vickussya/baya_feeder/docs/checks.md

# Design checks (generated by build.py - do not edit by hand)

Parameters: wheel 80 mm x 28 mm, 6 pockets, bowl 140 x 45 mm, chute 60 deg

## Dosing

* Pocket volume (computed from the wheel solid, incl. fillets): **10.48 ml** (sharp-edged sector solid: 10.39 ml)
* Grams per pocket at 0.65 g/ml: **6.81 g**
* Dose 10 g -> 1 pockets = 6.8 g  (60 deg of wheel rotation)
* Dose 20 g -> 3 pockets = 20.4 g  (180 deg of wheel rotation)
* Dose 40 g -> 6 pockets = 40.9 g  (360 deg of wheel rotation)
* Pocket mouth (tangential) = 36.0 mm = 7.2 x pellet diameter (requirement >= 3x); axial width 22 mm = 4.4x
* Wheel-to-housing clearance: radial 0.7 mm, axial 0.7 mm (crest fillet 1.5 mm)

## Hopper

* Usable capacity up to the fill line: **1200 ml** = 780 g of pellets (funnel 274 ml + cylinder 117.9 mm); total to the rim 1388 ml
* Days of food at 40 g/day (2 x 20 g): **19.5 days**; at the default 2 x 20 g/day: 19.5 days; at 2 x 10 g/day: 39.0 days
* Mouth inner diameter 100 mm (>= 90); funnel wall slopes +X 70.4 deg, -X 60.5 deg, +-Y 62.8 deg (all >= 60 deg from horizontal)

## Bowl

* Inner diameter at brim **140 mm**, inner depth **45 mm**, spherical dish radius 76.9 mm
* Volume to the brim: **394 ml**; volume below the low front rim: 78 ml (a 40 g dose = 62 ml)
* Front (rabbit-facing) rim height 32 mm above the ground; back/side rim 58 mm
* Base diameter 168 mm = 1.20 x bowl diameter (>= 1.2); steel weight plate 106 x 3.2 mm = 222 g

## Assembly geometry

| result | check | detail |
|---|---|---|
| PASS | Chute outlet over bowl centre | outlet centre x=140.5 mm, bowl centre x=140.5 mm; outlet spans 113..168 inside bowl radius 70 |
| PASS | Drop height outlet -> bowl floor 60-100 mm | 80.0 mm |
| PASS | Chute slope >= 60 deg from horizontal | 60 deg (30 deg from vertical) |
| PASS | Chute internal width 35-40 mm (>= 7x pellet) | 40 mm = 8.0x pellet diameter |
| PASS | Chute clears the bowl rim | 35.0 mm between outlet and rim top |
| PASS | Hopper stays on the housing side of the pen wall | hopper max x=45.8 mm, pen wall starts at x=49.5 mm |

## Print volume (220 x 220 x 250)

| result | part | bed footprint x height (mm) |
|---|---|---|
| PASS | 01_hopper_body | 107.6 x 110.6 x 222.9 |
| PASS | 02_hopper_lid | 107.6 x 107.6 x 21.0 |
| PASS | 03_wheel_housing | 91.0 x 92.8 x 40.1 |
| PASS | 03b_bearing_cap | 91.0 x 91.0 x 13.7 |
| PASS | 04_pocket_wheel | 80.0 x 80.0 x 44.7 |
| PASS | 05_motor_mount | 70.0 x 70.0 x 19.0 |
| PASS | 06_chute | 210.2 x 52.0 x 238.2 |
| PASS | 06b_chute_flap_TPU | 66.0 x 51.2 x 17.2 |
| PASS | 07_enclosure | 91.0 x 91.0 x 89.0 |
| PASS | 07b_enclosure_lid | 91.0 x 91.0 x 10.0 |
| PASS | 08_bowl | 134.2 x 146.9 x 49.0 |
| PASS | 09_bowl_base | 168.0 x 168.0 x 16.0 |
| PASS | 10_wall_bracket | 212.8 x 150.0 x 4.0 |

## Minimum wall thickness (designed values; slicer: >= 4 perimeters, 100% on chute/bowl)

| result | feature | thickness (mm) | limit |
|---|---|---|---|
| PASS | Chute tube wall (reachable) | 4.00 | >= 3.0 |
| PASS | Chute flange (reachable end is the tube, flange is outside) | 5.00 | >= 2.4 |
| PASS | Bowl dish wall (min normal distance, sampled) | 3.87 | >= 3.0 |
| PASS | Bowl floor | 4.00 | >= 3.0 |
| PASS | Bowl base: floor under recess | 6.00 | >= 3.0 |
| PASS | Bowl base: floor under M4 counterbore | 3.80 | >= 3.0 |
| PASS | Bracket plate | 4.00 | >= 3.0 |
| PASS | Hopper cylinder wall | 3.80 | >= 2.4 |
| PASS | Hopper funnel wall (normal) | 3.31 | >= 2.4 |
| PASS | Hopper window wall behind strip | 2.80 | >= 2.4 |
| PASS | Hopper lid disc under finger dish | 2.80 | >= 2.4 |
| PASS | Hopper lid under gasket groove | 3.50 | >= 2.4 |
| PASS | Hopper lid plug ring | 5.50 | >= 2.4 |
| PASS | Flange under groove | 2.80 | >= 2.4 |
| PASS | Housing side wall (HB - R_i) | 4.80 | >= 2.4 |
| PASS | Housing motor-side wall | 8.00 | >= 2.4 |
| PASS | Housing wall behind reed pocket | 3.00 | >= 2.4 |
| PASS | Housing wall under insert holes | 3.00 | >= 2.4 |
| PASS | Housing tongue ridge | 2.40 | >= 2.4 |
| PASS | Bearing cap | 8.00 | >= 2.4 |
| PASS | Wheel side wall | 3.00 | >= 2.4 |
| PASS | Wheel web between pockets | 4.00 | >= 2.4 |
| PASS | Wheel hub around D-bore | 5.40 | >= 2.4 |
| PASS | Motor-mount post around screw hole | 2.80 | >= 2.4 |
| PASS | Motor-mount plate | 5.00 | >= 2.4 |
| PASS | Enclosure wall | 3.00 | >= 2.4 |
| PASS | Enclosure lid | 4.00 | >= 2.4 |

Intentionally thin (TPU, not subject to the rule): chute flap 1.2 mm, living hinge 0.6 mm, sleeve 2.0 mm.

## Entrapment gaps on rabbit-reachable surfaces (forbidden window 6-25 mm)

| result | gap | size (mm) | note |
|---|---|---|---|
| PASS | Chute <-> bracket plate hole | 0.4 | chute leaves the pen wall through the plate |
| PASS | Bowl cone <-> base recess wall (at base top) | 1.0 | bowl sits in a recess |
| PASS | Bowl foot <-> recess wall (hidden underneath) | 4.4 | below the bowl, no access |
| PASS | Chute outlet <-> bowl brim (vertical) | 35.0 | open space, head can pass |
| PASS | Chute outlet <-> front rim notch floor | 61.2 | open space |
| PASS | Hopper window slot (8 mm) - covered by 1 mm strip, out of reach | 0.0 | covered, no opening |
| PASS | Bracket slots (5 x 14 mm), outside the pen | 5.0 | narrow dimension < 6 |

The pen wall / bars themselves are the user's: leave a hole of about 49 mm wide x 96 mm high (the bracket plate closes it to 0.4 mm).

## Interference check of the assembled parts

* intended stretch fit (TPU sleeve over chute end): 06_chute / 06b_chute_flap_TPU = 1326 mm3 (0.4 mm interference)
* PASS: no volumetric overlap between any of the 13 parts (threshold 5 mm3 = touching faces)

## Overall: ALL CHECKS PASS
## STL validation (reloaded with trimesh)

| result | file | triangles | volume (ml) | extents (mm) |
|---|---|---|---|---|
| PASS | stl/01_hopper_body.stl | 7612 | 258.6 | 107.6 x 110.6 x 222.9 |
| PASS | stl/02_hopper_lid.stl | 12614 | 68.5 | 107.6 x 107.6 x 21.0 |
| PASS | stl/03_wheel_housing.stl | 14144 | 142.0 | 91.0 x 92.8 x 40.1 |
| PASS | stl/03b_bearing_cap.stl | 3060 | 65.8 | 91.0 x 91.0 x 13.7 |
| PASS | stl/04_pocket_wheel.stl | 5510 | 80.9 | 80.0 x 80.0 x 44.7 |
| PASS | stl/05_motor_mount.stl | 7112 | 25.1 | 70.0 x 70.0 x 19.0 |
| PASS | stl/06_chute.stl | 2080 | 202.0 | 210.2 x 52.0 x 238.2 |
| PASS | stl/06b_chute_flap_TPU.stl | 76 | 9.8 | 66.0 x 51.2 x 17.2 |
| PASS | stl/07_enclosure.stl | 6232 | 125.3 | 91.0 x 91.0 x 89.0 |
| PASS | stl/07b_enclosure_lid.stl | 9168 | 32.2 | 91.0 x 91.0 x 10.0 |
| PASS | stl/08_bowl.stl | 55774 | 194.4 | 134.2 x 146.9 x 49.0 |
| PASS | stl/09_bowl_base.stl | 20168 | 259.1 | 168.0 x 167.9 x 16.0 |
| PASS | stl/10_wall_bracket.stl | 2656 | 107.2 | 212.8 x 150.0 x 4.0 |
