vickussya/baya_feeder/step/rabbit_feeder_assembly.step

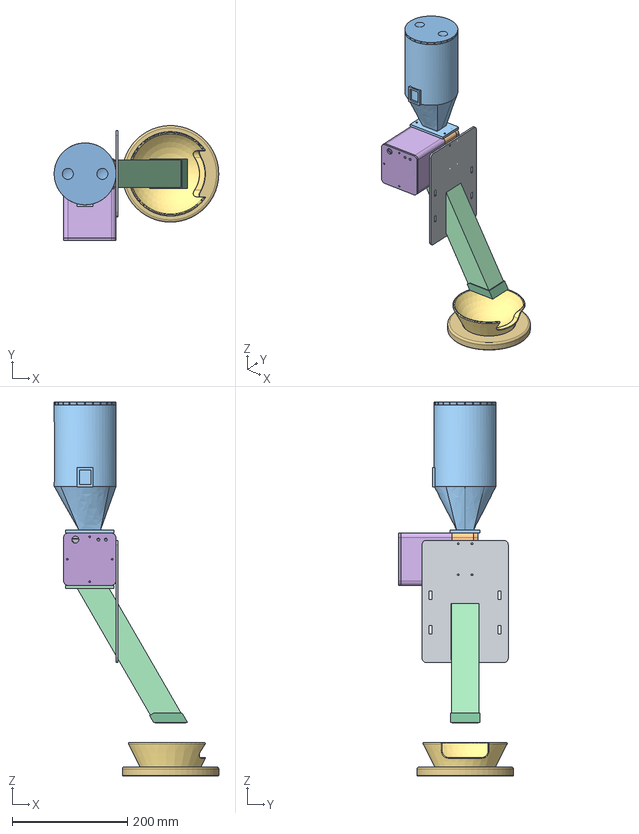
[picture p8: CAD file, 2026-10-19]
step/rabbit_feeder_assembly.step
286.3 x 199.7 x 650.2 mm
01_hopper_body
02_hopper_lid
03_wheel_housing
03b_bearing_cap
04_pocket_wheel
05_motor_mount
06_chute
06b_chute_flap_TPU
07_enclosure
07b_enclosure_lid
08_bowl
09_bowl_base
10_wall_bracket
