vickussya/baya_feeder/step/03b_bearing_cap.step

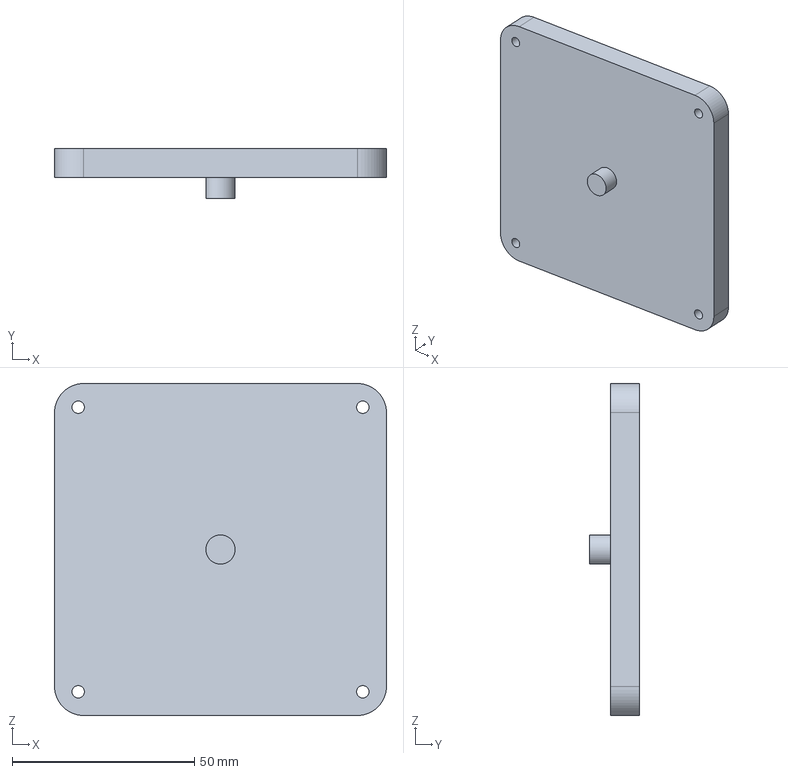
[picture p9: CAD file, 2026-10-19]
step/03b_bearing_cap.step
91.0 x 13.7 x 91.0 mm
