vickussya/baya_feeder/step/10_wall_bracket.step

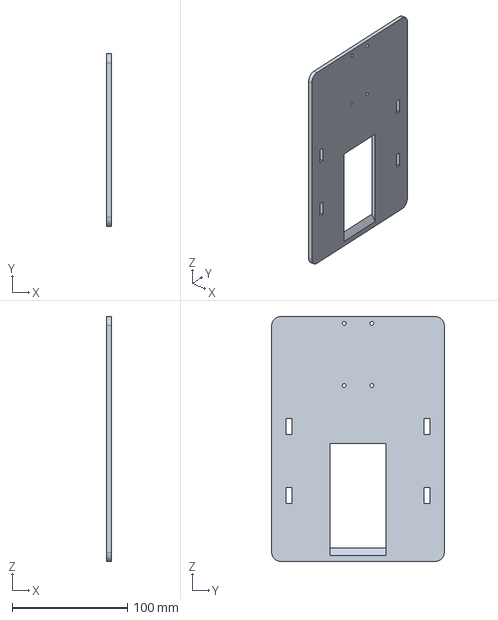
[picture p10: CAD file, 2026-10-19]
step/10_wall_bracket.step
4.00 x 150.0 x 212.8 mm
