vickussya/baya_feeder/step/07_enclosure.step

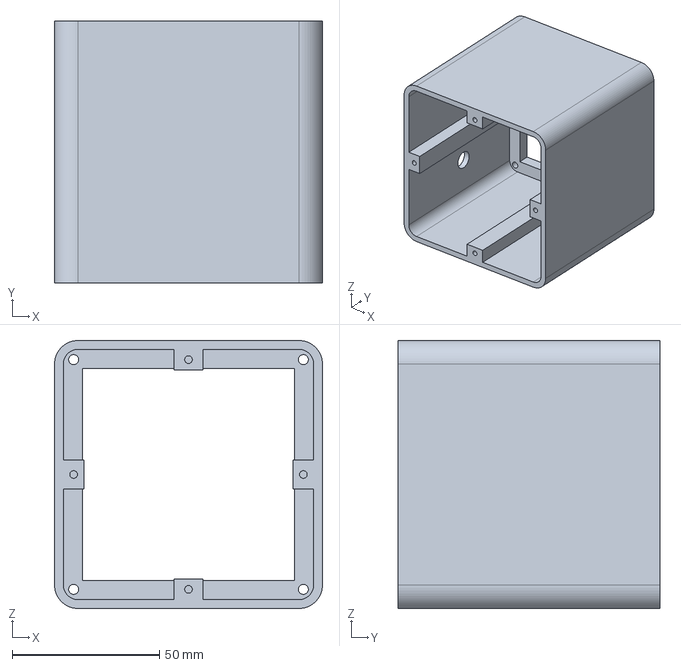
[picture p11: CAD file, 2026-10-19]
step/07_enclosure.step
91.0 x 89.0 x 91.0 mm
