vickussya/baya_feeder/step/06b_chute_flap_TPU.step

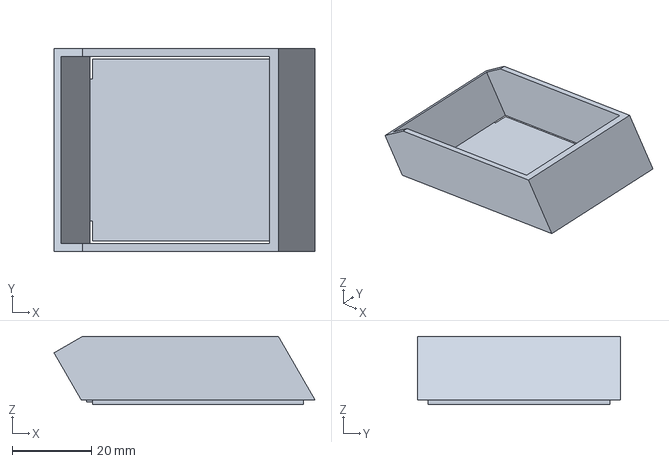
[picture p12: CAD file, 2026-10-19]
step/06b_chute_flap_TPU.step
66.0 x 51.2 x 17.2 mm
