vickussya/baya_feeder/step/01_hopper_body.step

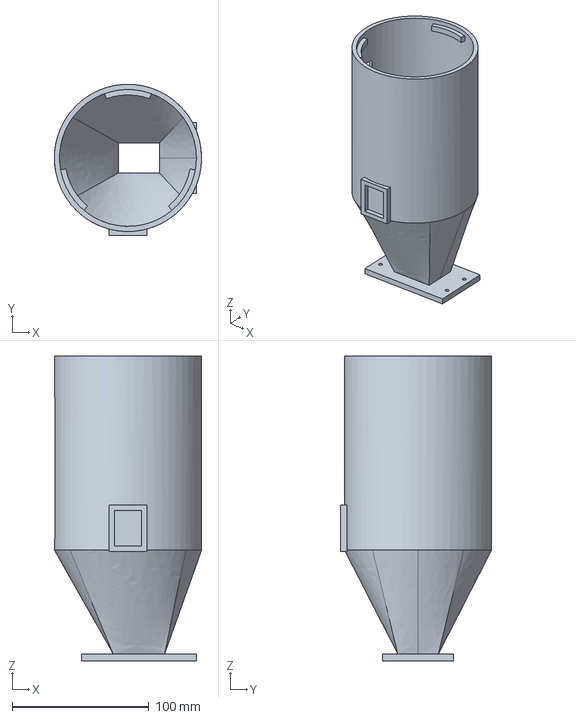
[picture p13: CAD file, 2026-10-19]
step/01_hopper_body.step
107.5 x 110.6 x 222.9 mm
