vickussya/baya_feeder/step/07b_enclosure_lid.step

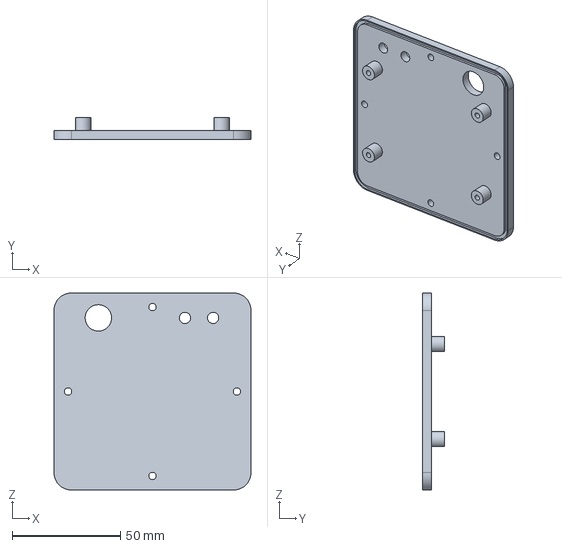
[picture p14: CAD file, 2026-10-19]
step/07b_enclosure_lid.step
91.0 x 10.0 x 91.0 mm
