vickussya/baya_feeder/step/02_hopper_lid.step

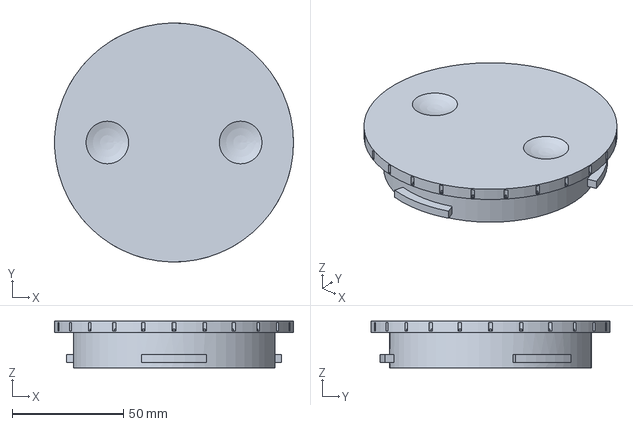
[picture p15: CAD file, 2026-10-19]
step/02_hopper_lid.step
107.6 x 107.6 x 21.0 mm
