vickussya/baya_feeder/step/08_bowl.step

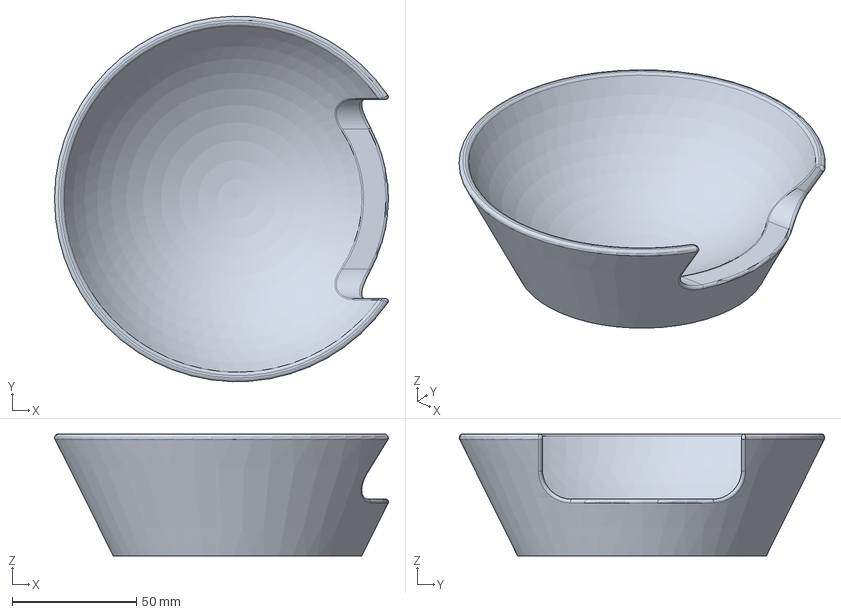
[picture p16: CAD file, 2026-10-19]
step/08_bowl.step
134.2 x 146.9 x 49.0 mm
