vickussya/baya_feeder/step/09_bowl_base.step

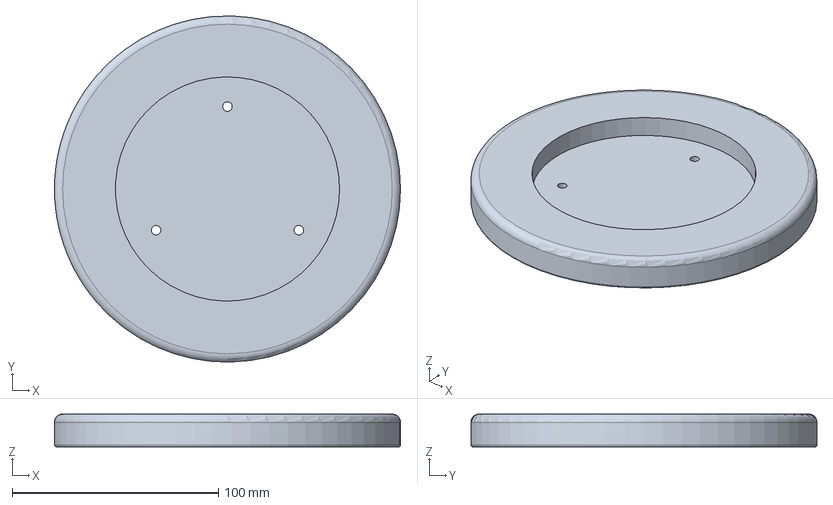
[picture p17: CAD file, 2026-10-19]
step/09_bowl_base.step
168.0 x 167.9 x 16.0 mm
