vickussya/baya_feeder/step/05_motor_mount.step

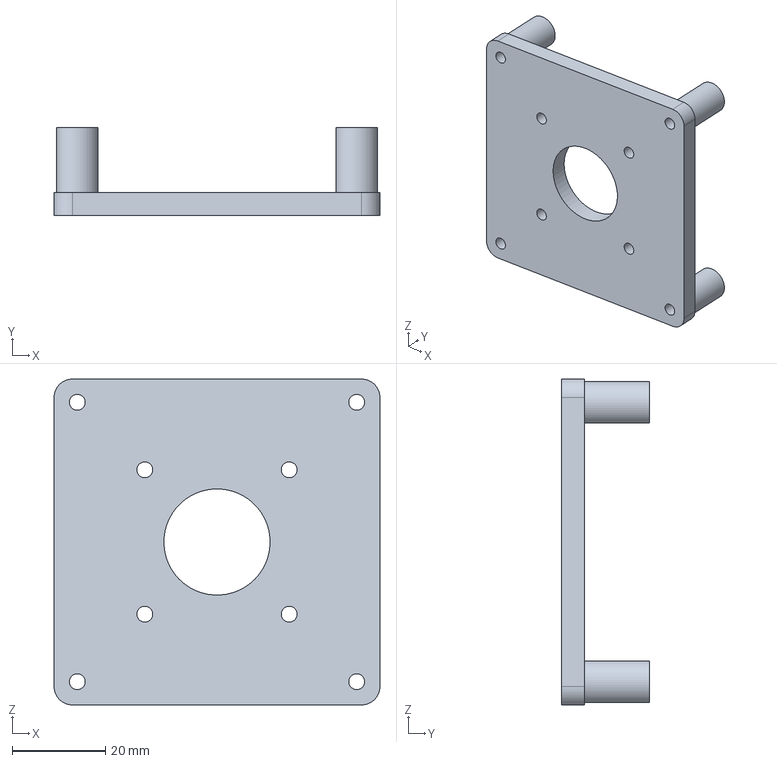
[picture p18: CAD file, 2026-10-19]
step/05_motor_mount.step
70.0 x 19.0 x 70.0 mm
