vickussya/baya_feeder/step/06_chute.step

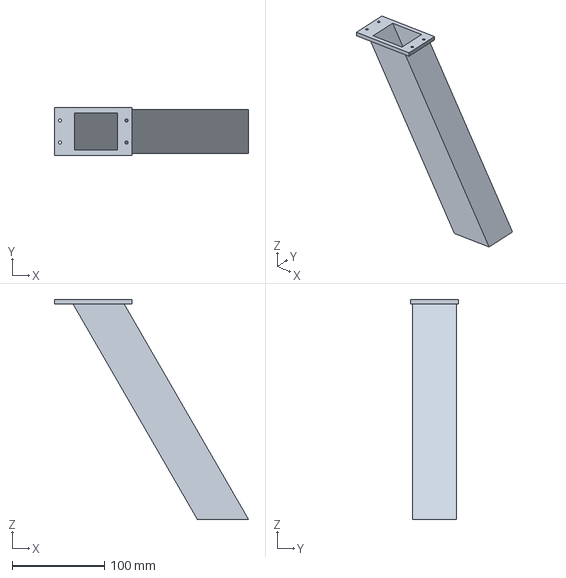
[picture p19: CAD file, 2026-10-19]
step/06_chute.step
210.2 x 52.0 x 238.2 mm
