vickussya/baya_feeder/step/03_wheel_housing.step

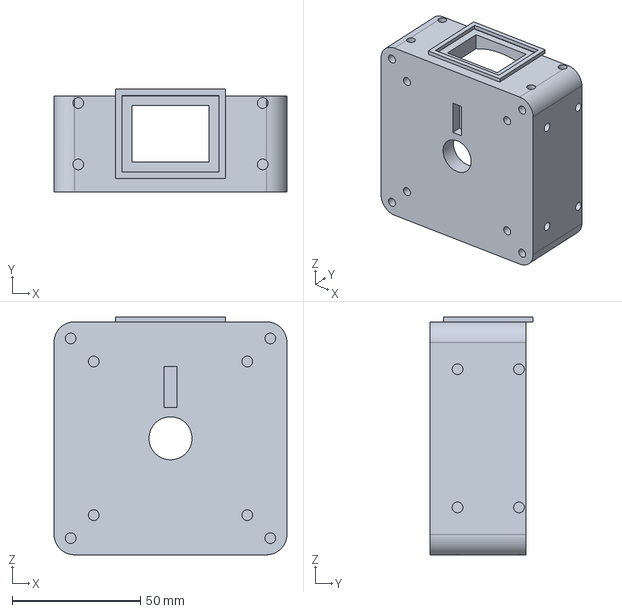
[picture p20: CAD file, 2026-10-19]
step/03_wheel_housing.step
91.0 x 40.1 x 92.8 mm
