vickussya/baya_feeder/step/04_pocket_wheel.step

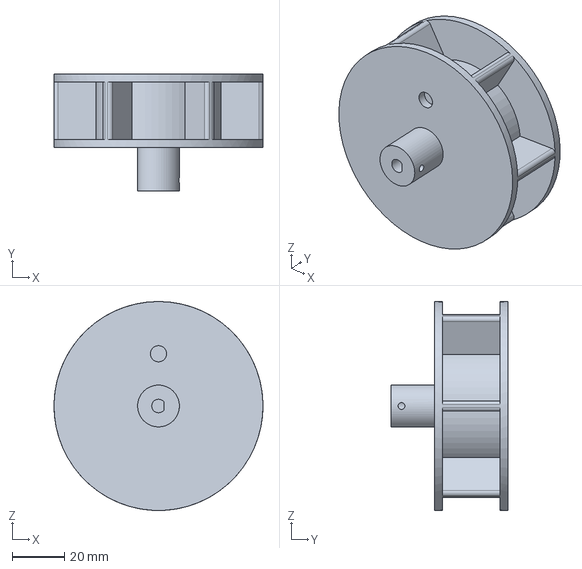
[picture p21: CAD file, 2026-10-19]
step/04_pocket_wheel.step
80.0 x 44.7 x 80.0 mm
