vickussya/baya_feeder/(list of files, cad)

Other CAD files:
baya feeder.FCStd
stl/01_hopper_body.stl
stl/02_hopper_lid.stl
stl/03_wheel_housing.stl
stl/03b_bearing_cap.stl
stl/04_pocket_wheel.stl
stl/05_motor_mount.stl
stl/06_chute.stl
stl/06b_chute_flap_TPU.stl
stl/07_enclosure.stl
stl/07b_enclosure_lid.stl
stl/08_bowl.stl
stl/09_bowl_base.stl
stl/10_wall_bracket.stl
