vickussya/baya_feeder/build.py

#!/usr/bin/env python3
"""
Build driver for feeder.py:  STL export, design checks (docs/checks.md) and the assembly render.

    python build.py            # everything
    python build.py --no-render
"""
import itertools
import math
import os
import sys
import time

import numpy as np
import trimesh
from PIL import Image, ImageDraw, ImageFont

import feeder as f
from feeder import V

HERE = os.path.dirname(os.path.abspath(__file__))
STL_DIR = os.path.join(HERE, "stl")
DOC_DIR = os.path.join(HERE, "docs")

COLORS = {
    "01_hopper_body": (86, 156, 214), "02_hopper_lid": (46, 108, 168),
    "03_wheel_housing": (232, 150, 60), "03b_bearing_cap": (200, 120, 40),
    "04_pocket_wheel": (220, 70, 70), "05_motor_mount": (120, 120, 130),
    "06_chute": (90, 180, 120), "06b_chute_flap_TPU": (30, 120, 70),
    "07_enclosure": (150, 110, 190), "07b_enclosure_lid": (120, 80, 160),
    "08_bowl": (240, 205, 80), "09_bowl_base": (170, 140, 60),
    "10_wall_bracket": (150, 160, 170),
}
INTENDED_FIT = {("06_chute", "06b_chute_flap_TPU")}
LABELS = {
    "01_hopper_body": "1  Hopper body", "02_hopper_lid": "2  Hopper lid (bayonet)",
    "03_wheel_housing": "3  Wheel housing", "03b_bearing_cap": "3b Bearing cap",
    "04_pocket_wheel": "4  Pocket wheel (6x)", "05_motor_mount": "5  Motor mount",
    "06_chute": "6  Chute", "06b_chute_flap_TPU": "6b Chute flap (TPU)",
    "07_enclosure": "7  Electronics enclosure", "07b_enclosure_lid": "7b Enclosure lid",
    "08_bowl": "8  Bowl", "09_bowl_base": "9  Bowl base + weight",
    "10_wall_bracket": "10 Wall / cage bracket",
}


# =============================================================================
# CHECKS
# =============================================================================
def run_checks(parts):
    L = []                     # markdown lines
    ok_all = True

    def line(s=""):
        L.append(s)

    def check(name, cond, detail):
        nonlocal ok_all
        ok_all &= bool(cond)
        line(f"| {'PASS' if cond else '**FAIL**'} | {name} | {detail} |")

    line("# Design checks (generated by build.py - do not edit by hand)\n")
    line(f"Parameters: wheel {f.wheel_od:.0f} mm x {f.wheel_w:.0f} mm, {f.n_pockets} pockets, "
         f"bowl {f.bowl_diameter:.0f} x {f.bowl_depth:.0f} mm, chute {f.chute_angle:.0f} deg\n")

    # ---- dosing --------------------------------------------------------------
    wheel = parts["04_pocket_wheel"]
    pocket_ml = f.pocket_volume_ml(wheel)
    pocket_g = pocket_ml * f.bulk_density
    line("## Dosing\n")
    line(f"* Pocket volume (computed from the wheel solid, incl. fillets): **{pocket_ml:.2f} ml** "
         f"(sharp-edged sector solid: {f.vol_ml(f.pocket_prism(f.R_w)):.2f} ml)")
    line(f"* Grams per pocket at {f.bulk_density} g/ml: **{pocket_g:.2f} g**")
    for g in (f.dose_min_g, f.dose_default_g, f.dose_max_g):
        n = round(g / pocket_g)
        line(f"* Dose {g:.0f} g -> {n} pockets = {n * pocket_g:.1f} g  ({n * 360 // f.n_pockets} deg of wheel rotation)")
    pockets_default = round(f.dose_default_g / pocket_g)
    mouth = 2 * f.R_w * math.sin(math.radians(180 / f.n_pockets)) - f.pocket_web
    line(f"* Pocket mouth (tangential) = {mouth:.1f} mm = {mouth / f.pellet_diameter:.1f} x pellet diameter "
         f"(requirement >= 3x); axial width {f.pocket_w:.0f} mm = {f.pocket_w / f.pellet_diameter:.1f}x")
    line(f"* Wheel-to-housing clearance: radial {f.wheel_clear} mm, axial {f.wheel_clear} mm (crest fillet {f.pocket_rim_fillet} mm)\n")

    # ---- hopper --------------------------------------------------------------
    funnel_ml = f.V_funnel_ml
    usable_ml = funnel_ml + math.pi * (f.hopper_d_in / 2) ** 2 * f.cyl_h / 1000
    total_ml = usable_ml + math.pi * (f.hopper_d_in / 2) ** 2 * f.headroom / 1000
    grams = usable_ml * f.bulk_density
    run_x_plus = (f.hopper_d_in / 2 + f.hopper_dx) - f.port_top_x / 2
    run_x_minus = (f.hopper_d_in / 2 - f.hopper_dx) - f.port_top_x / 2
    run_y = f.hopper_d_in / 2 - f.pocket_w / 2
    slopes = {k: math.degrees(math.atan2(f.funnel_h, r)) for k, r in
              (("+X", run_x_plus), ("-X", run_x_minus), ("+-Y", run_y))}
    line("## Hopper\n")
    line(f"* Usable capacity up to the fill line: **{usable_ml:.0f} ml** = {grams:.0f} g of pellets "
         f"(funnel {funnel_ml:.0f} ml + cylinder {f.cyl_h:.1f} mm); total to the rim {total_ml:.0f} ml")
    line(f"* Days of food at {f.fed_g_per_day_max:.0f} g/day (2 x {f.dose_max_g / 2:.0f} g): "
         f"**{grams / f.fed_g_per_day_max:.1f} days**; at the default 2 x {f.dose_default_g:.0f} g/day: "
         f"{grams / (f.dose_default_g * 2):.1f} days; at 2 x {f.dose_min_g:.0f} g/day: {grams / (f.dose_min_g * 2):.1f} days")
    line(f"* Mouth inner diameter {f.hopper_d_in:.0f} mm (>= 90); funnel wall slopes "
         + ", ".join(f"{k} {v:.1f} deg" for k, v in slopes.items()) + " (all >= 60 deg from horizontal)\n")

    # ---- bowl ----------------------------------------------------------------
    cav_ml = f.bowl_cavity_volume_ml()
    outer, cav = f._bowl_local()
    front = f.I(cav, f.box(-f.R_cap - 1, f.R_cap + 1, -f.R_cap - 1, f.R_cap + 1, 0, f.bowl_front_z))
    front_ml = front.Volume() / 1000
    line("## Bowl\n")
    line(f"* Inner diameter at brim **{f.bowl_diameter:.0f} mm**, inner depth **{f.bowl_depth:.0f} mm**, "
         f"spherical dish radius {f.R_cap:.1f} mm")
    line(f"* Volume to the brim: **{cav_ml:.0f} ml**; volume below the low front rim: {front_ml:.0f} ml "
         f"(a {f.dose_max_g:.0f} g dose = {f.dose_max_g / f.bulk_density:.0f} ml)")
    line(f"* Front (rabbit-facing) rim height {f.rim_height:.0f} mm above the ground; back/side rim "
         f"{f.bowl_foot_z_above_ground + f.bowl_ztop:.0f} mm")
    line(f"* Base diameter {f.base_d:.0f} mm = {f.base_d / f.bowl_diameter:.2f} x bowl diameter (>= 1.2); "
         f"steel weight plate {f.weight_d:.0f} x {f.weight_t} mm = "
         f"{math.pi * (f.weight_d / 20) ** 2 * f.weight_t / 10 * f.steel_density:.0f} g\n")

    # ---- assembly geometry ---------------------------------------------------
    chute = parts["06_chute"]
    outlet_faces = [fc for fc in chute.Faces()
                    if abs(fc.normalAt().z + 1) < 1e-6 and abs(fc.Center().z - f.z_out) < 1e-3]
    out_cx = sum(fc.Center().x * fc.Area() for fc in outlet_faces) / sum(fc.Area() for fc in outlet_faces)
    bowl_world = parts["08_bowl"]
    bb_b = bowl_world.BoundingBox()
    rim_top_z = f.z_bowl_foot + f.bowl_ztop
    drop = f.z_out - (f.z_bowl_foot + f.bowl_floor_t)
    chute_min_z = chute.BoundingBox().zmin
    half_w = (f.chute_in + 2 * f.chute_wall) / f.sin_a / 2
    line("## Assembly geometry\n")
    line("| result | check | detail |")
    line("|---|---|---|")
    check("Chute outlet over bowl centre", abs(out_cx - f.x_bowl) < 0.5,
          f"outlet centre x={out_cx:.1f} mm, bowl centre x={f.x_bowl:.1f} mm; outlet spans "
          f"{out_cx - half_w:.0f}..{out_cx + half_w:.0f} inside bowl radius {f.bowl_diameter / 2:.0f}")
    check("Drop height outlet -> bowl floor 60-100 mm", 60 <= drop <= 100 and abs(chute_min_z - f.z_out) < 1e-3,
          f"{drop:.1f} mm")
    check("Chute slope >= 60 deg from horizontal", f.chute_angle >= 60, f"{f.chute_angle:.0f} deg "
          f"({90 - f.chute_angle:.0f} deg from vertical)")
    check("Chute internal width 35-40 mm (>= 7x pellet)", 35 <= f.chute_in <= 40 and f.chute_in >= 7 * f.pellet_diameter,
          f"{f.chute_in:.0f} mm = {f.chute_in / f.pellet_diameter:.1f}x pellet diameter")
    check("Chute clears the bowl rim", f.z_out - rim_top_z > 0, f"{f.z_out - rim_top_z:.1f} mm between outlet and rim top")
    check("Hopper stays on the housing side of the pen wall",
          f.hopper_dx + f.r_ho <= f.x_plate1 - 1.0, f"hopper max x={f.hopper_dx + f.r_ho:.1f} mm, "
          f"pen wall starts at x={f.x_plate1:.1f} mm")
    line()

    # ---- print volume ---------------------------------------------------------
    line("## Print volume (220 x 220 x 250)\n")
    line("| result | part | bed footprint x height (mm) |")
    line("|---|---|---|")
    pv = f.print_volume
    for name, shape in parts.items():
        bb = f.to_print(name, shape).BoundingBox()
        fits = (bb.xlen <= pv[0] and bb.ylen <= pv[1] or bb.xlen <= pv[1] and bb.ylen <= pv[0]) and bb.zlen <= pv[2]
        ok_all &= fits
        line(f"| {'PASS' if fits else '**FAIL**'} | {name} | {bb.xlen:.1f} x {bb.ylen:.1f} x {bb.zlen:.1f} |")
    line()

    # ---- wall thickness -------------------------------------------------------
    line("## Minimum wall thickness (designed values; slicer: >= 4 perimeters, 100% on chute/bowl)\n")
    line("| result | feature | thickness (mm) | limit |")
    line("|---|---|---|---|")
    funnel_wall_n = f.hop_wall * math.sin(math.radians(min(slopes.values())))
    # bowl: shortest distance from the dish surface to the outer cone profile
    th = bowl_min_wall()
    walls = [
        ("Chute tube wall (reachable)", f.chute_wall, f.wall_reach),
        ("Chute flange (reachable end is the tube, flange is outside)", f.flange_t, f.wall_min),
        ("Bowl dish wall (min normal distance, sampled)", th, f.wall_reach),
        ("Bowl floor", f.bowl_floor_t, f.wall_reach),
        ("Bowl base: floor under recess", f.base_t - f.base_recess_depth, f.wall_reach),
        ("Bowl base: floor under M4 counterbore", f.base_t - f.base_recess_depth - 2.2, f.wall_reach),
        ("Bracket plate", f.plate_t, f.wall_reach),
        ("Hopper cylinder wall", f.hop_wall, f.wall_min),
        ("Hopper funnel wall (normal)", funnel_wall_n, f.wall_min),
        ("Hopper window wall behind strip", f.hop_wall - f.window_strip_t, f.wall_min),
        ("Hopper lid disc under finger dish", f.lid_t - 2.2, f.wall_min),
        ("Hopper lid under gasket groove", f.lid_t - f.lid_gasket_d, f.wall_min),
        ("Hopper lid plug ring", 5.5, f.wall_min),
        ("Flange under groove", f.flange_t - (f.tongue_h + 0.4), f.wall_min),
        ("Housing side wall (HB - R_i)", f.HB - f.R_i, f.wall_min),
        ("Housing motor-side wall", f.housing_back_wall, f.wall_min),
        ("Housing wall behind reed pocket", f.housing_back_wall - 5.0, f.wall_min),
        ("Housing wall under insert holes", f.housing_back_wall - f.insert_depth, f.wall_min),
        ("Housing tongue ridge", f.tongue_w, f.wall_min),
        ("Bearing cap", f.cap_t, f.wall_min),
        ("Wheel side wall", f.wheel_side_wall, f.wall_min),
        ("Wheel web between pockets", f.pocket_web, f.wall_min),
        ("Wheel hub around D-bore", (f.hub_d - (f.shaft_d + 0.2)) / 2, f.wall_min),
        ("Motor-mount post around screw hole", (f.post_d - f.screw_clear_d) / 2, f.wall_min),
        ("Motor-mount plate", f.motor_plate_t, f.wall_min),
        ("Enclosure wall", f.enc_wall, f.wall_min),
        ("Enclosure lid", f.lid_enc_t, f.wall_min),
    ]
    for n, t, lim in walls:
        ok = t >= lim - 1e-9
        ok_all &= ok
        line(f"| {'PASS' if ok else '**FAIL**'} | {n} | {t:.2f} | >= {lim} |")
    line("\nIntentionally thin (TPU, not subject to the rule): chute flap 1.2 mm, living hinge 0.6 mm, sleeve 2.0 mm.\n")

    # ---- gaps -----------------------------------------------------------------
    line("## Entrapment gaps on rabbit-reachable surfaces (forbidden window 6-25 mm)\n")
    line("| result | gap | size (mm) | note |")
    line("|---|---|---|---|")
    r_recess = f.bowl_foot_d / 2 + f.base_recess_clear
    cone_r = f.bowl_foot_d / 2 + (f.bowl_rout_rim - f.bowl_foot_d / 2) * (f.base_t - f.bowl_foot_z_above_ground) / f.bowl_ztop
    gaps = [
        ("Chute <-> bracket plate hole", f.plate_hole_clear, "chute leaves the pen wall through the plate"),
        ("Bowl cone <-> base recess wall (at base top)", r_recess - cone_r, "bowl sits in a recess"),
        ("Bowl foot <-> recess wall (hidden underneath)", r_recess - f.bowl_foot_d / 2, "below the bowl, no access"),
        ("Chute outlet <-> bowl brim (vertical)", f.z_out - rim_top_z, "open space, head can pass"),
        ("Chute outlet <-> front rim notch floor", f.z_out - (f.z_bowl_foot + f.bowl_front_z), "open space"),
        ("Hopper window slot (8 mm) - covered by 1 mm strip, out of reach", 0.0, "covered, no opening"),
        ("Bracket slots (5 x 14 mm), outside the pen", 5.0, "narrow dimension < 6"),
    ]
    for n, g, note in gaps:
        ok = not (f.gap_forbidden[0] <= g <= f.gap_forbidden[1])
        ok_all &= ok
        line(f"| {'PASS' if ok else '**FAIL**'} | {n} | {g:.1f} | {note} |")
    line("\nThe pen wall / bars themselves are the user's: leave a hole of about "
         f"{f.chute_in + 2 * f.chute_wall + 2 * f.plate_hole_clear:.0f} mm wide x "
         f"{(f.chute_in + 2 * f.chute_wall) / f.cos_a:.0f} mm high (the bracket plate closes it to {f.plate_hole_clear} mm).\n")

    # ---- interferences --------------------------------------------------------
    line("## Interference check of the assembled parts\n")
    names = list(parts)
    bad = []
    for a, b in itertools.combinations(names, 2):
        ba, bb_ = parts[a].BoundingBox(), parts[b].BoundingBox()
        if (ba.xmax < bb_.xmin or bb_.xmax < ba.xmin or ba.ymax < bb_.ymin or bb_.ymax < ba.ymin
                or ba.zmax < bb_.zmin or bb_.zmax < ba.zmin):
            continue
        v = parts[a].intersect(parts[b]).Volume()
        if (a, b) in INTENDED_FIT:
            line(f"* intended stretch fit (TPU sleeve over chute end): {a} / {b} = {v:.0f} mm3 "
                 f"({f.chute_wall and 0.4} mm interference)")
            continue
        if v > 5.0:
            bad.append((a, b, v))
    if bad:
        ok_all = False
        for a, b, v in bad:
            line(f"* **FAIL** {a} intersects {b}: {v:.1f} mm3")
    else:
        line(f"* PASS: no volumetric overlap between any of the {len(names)} parts (threshold 5 mm3 = touching faces)")
    line()
    line(f"## Overall: {'ALL CHECKS PASS' if ok_all else 'SOME CHECKS FAILED'}")
    return "\n".join(L), ok_all


def bowl_min_wall():
    """min distance from the spherical dish surface to the outer cone profile (r,z plane)"""
    P = [(0, 0), (f.bowl_foot_d / 2, 0), (f.bowl_rout_rim, f.bowl_ztop)]
    best = 1e9
    for i in range(0, 361):
        ang = math.radians(i * 0.25)                                 # polar angle on the dish
        r, z = f.R_cap * math.sin(ang), f.bowl_zc - f.R_cap * math.cos(ang)
        if z > f.bowl_ztop or z < f.bowl_floor_t - 1e-9:
            continue
        for (x0, z0), (x1, z1) in zip(P[:-1], P[1:]):
            dx, dz = x1 - x0, z1 - z0
            t = max(0, min(1, ((r - x0) * dx + (z - z0) * dz) / (dx * dx + dz * dz)))
            best = min(best, math.hypot(r - (x0 + t * dx), z - (z0 + t * dz)))
    return best


# =============================================================================
# RENDER (small z-buffer rasteriser, orthographic)
# =============================================================================
def tessellate(shape, tol=0.15, ang=0.2):
    verts, tris = shape.tessellate(tol, ang)
    v = np.array([[p.x, p.y, p.z] for p in verts], dtype=np.float64)
    t = np.array(tris, dtype=np.int64)
    return v, t


def camera_basis(az_deg, el_deg):
    """camera looks towards the origin from direction (az, el); returns right, up, forward"""
    az, el = math.radians(az_deg), math.radians(el_deg)
    pos = np.array([math.cos(el) * math.sin(az), -math.cos(el) * math.cos(az), math.sin(el)])
    fwd = -pos
    right = np.cross(fwd, [0, 0, 1.0])
    right /= np.linalg.norm(right)
    up = np.cross(right, fwd)
    return right, up, fwd


def render_view(meshes, az, el, width, ss=2, bg=(246, 247, 249), margin=40, return_proj=False):
    right, up, fwd = camera_basis(az, el)
    allv = np.vstack([m[0] for m in meshes])
    cen = (allv.min(0) + allv.max(0)) / 2
    P = (allv - cen) @ np.stack([right, up, fwd], axis=1)
    xmin, xmax, ymin, ymax = P[:, 0].min(), P[:, 0].max(), P[:, 1].min(), P[:, 1].max()
    scale = (width * ss - 2 * margin * ss) / (xmax - xmin)
    H = int((ymax - ymin) * scale + 2 * margin * ss)
    Wd = width * ss
    img = np.zeros((H, Wd, 3), dtype=np.float32)
    img[:] = bg
    zbuf = np.full((H, Wd), -1e18)
    light1 = np.array([-0.45, -0.55, 0.70]); light1 /= np.linalg.norm(light1)
    light2 = np.array([0.7, 0.2, 0.3]); light2 /= np.linalg.norm(light2)
    for (v, t, col) in meshes:
        pv = (v - cen) @ np.stack([right, up, fwd], axis=1)
        sx = (pv[:, 0] - xmin) * scale + margin * ss
        sy = H - ((pv[:, 1] - ymin) * scale + margin * ss)
        dz = -pv[:, 2]                                         # larger = closer to camera
        col = np.array(col, dtype=np.float32)
        a, b, c = v[t[:, 0]], v[t[:, 1]], v[t[:, 2]]
        n = np.cross(b - a, c - a)
        ln = np.linalg.norm(n, axis=1)
        n = n / np.maximum(ln[:, None], 1e-12)
        facing = n @ (-fwd)
        n = np.where((facing < 0)[:, None], -n, n)             # two-sided
        shade = 0.30 + 0.62 * np.clip(n @ light1, 0, 1) + 0.28 * np.clip(n @ light2, 0, 1)
        shade = np.clip(shade, 0, 1.15)
        for k in range(len(t)):
            if ln[k] < 1e-9:
                continue
            i0, i1, i2 = t[k]
            x0, y0, x1, y1, x2, y2 = sx[i0], sy[i0], sx[i1], sy[i1], sx[i2], sy[i2]
            minx, maxx = int(max(0, math.floor(min(x0, x1, x2)))), int(min(Wd - 1, math.ceil(max(x0, x1, x2))))
            miny, maxy = int(max(0, math.floor(min(y0, y1, y2)))), int(min(H - 1, math.ceil(max(y0, y1, y2))))
            if maxx < minx or maxy < miny:
                continue
            den = (y1 - y2) * (x0 - x2) + (x2 - x1) * (y0 - y2)
            if abs(den) < 1e-12:
                continue
            gx, gy = np.meshgrid(np.arange(minx, maxx + 1) + 0.5, np.arange(miny, maxy + 1) + 0.5)
            w0 = ((y1 - y2) * (gx - x2) + (x2 - x1) * (gy - y2)) / den
            w1 = ((y2 - y0) * (gx - x2) + (x0 - x2) * (gy - y2)) / den
            w2 = 1 - w0 - w1
            m = (w0 >= -1e-6) & (w1 >= -1e-6) & (w2 >= -1e-6)
            if not m.any():
                continue
            zz = w0 * dz[i0] + w1 * dz[i1] + w2 * dz[i2]
            zs = zbuf[miny:maxy + 1, minx:maxx + 1]
            upd = m & (zz > zs)
            if upd.any():
                zs[upd] = zz[upd]
                img[miny:maxy + 1, minx:maxx + 1][upd] = np.clip(col * shade[k], 0, 255)
    im = Image.fromarray(np.clip(img, 0, 255).astype(np.uint8))
    im = im.resize((Wd // ss, H // ss), Image.LANCZOS)
    if return_proj:
        M = np.stack([right, up, fwd], axis=1)

        def proj(p):
            q = (np.asarray(p, dtype=float) - cen) @ M
            return (((q[0] - xmin) * scale + margin * ss) / ss, (H - ((q[1] - ymin) * scale + margin * ss)) / ss)
        return im, proj
    return im


def render_assembly(parts, path):
    meshes = []
    for name, shape in parts.items():
        v, t = tessellate(shape)
        meshes.append((v, t, COLORS[name]))
    t0 = time.time()
    iso = render_view(meshes, az=-52, el=24, width=1100)
    side = render_view(meshes, az=0, el=0, width=760)
    print(f"  rendered views in {time.time() - t0:.0f}s")
    # legend
    try:
        font = ImageFont.truetype("arial.ttf", 22)
        small = ImageFont.truetype("arial.ttf", 18)
    except OSError:
        font = small = ImageFont.load_default()
    legend_w = 380
    Hh = max(iso.height, side.height)
    canvas = Image.new("RGB", (iso.width + side.width + legend_w, Hh + 70), (246, 247, 249))
    canvas.paste(iso, (0, 70))
    canvas.paste(side, (iso.width, 70))
    d = ImageDraw.Draw(canvas)
    d.text((24, 18), "Automatic rabbit feeder - assembly overview (perspective-free views, mm)", fill=(30, 30, 40), font=font)
    d.text((iso.width + 10, 44), "side view (looking along +Y): hopper, wheel, 60 deg chute, bowl", fill=(80, 80, 90), font=small)
    x0 = iso.width + side.width + 24
    y = 90
    for name in parts:
        d.rectangle([x0, y, x0 + 26, y + 26], fill=COLORS[name], outline=(40, 40, 40))
        d.text((x0 + 38, y + 1), LABELS[name], fill=(30, 30, 40), font=small)
        y += 38
    y += 14
    for s in (f"Hopper {f.hopper_volume_ml:.0f} ml usable", f"Dose {f.dose_default_g:.0f} g = 3 pockets",
              f"Bowl {f.bowl_diameter:.0f} x {f.bowl_depth:.0f} mm", f"Drop {f.drop_height:.0f} mm, chute {f.chute_angle:.0f} deg",
              f"Feeder height {f.z_rim + f.lid_t - f.z_ground:.0f} mm"):
        d.text((x0, y), s, fill=(60, 60, 70), font=small)
        y += 28
    canvas.save(path)
    return canvas.size



def finalize_stl(path):
    """drop zero-area triangles, merge vertices, then validate (returns a dict for the report)"""
    m = trimesh.load(path, process=False)
    m.merge_vertices()
    m.update_faces(m.nondegenerate_faces())
    m.remove_unreferenced_vertices()
    m.export(path)
    chk = trimesh.load(path)
    return dict(tris=len(chk.faces), watertight=bool(chk.is_watertight), volume_ml=chk.volume / 1000.0,
                extents=tuple(float(x) for x in chk.extents))

# =============================================================================
def main(render=True):
    os.makedirs(STL_DIR, exist_ok=True)
    os.makedirs(DOC_DIR, exist_ok=True)
    t0 = time.time()
    stl_info = {}
    parts = f.build_all()
    print(f"built {len(parts)} parts in {time.time() - t0:.1f}s")
    for name, shape in parts.items():
        assert shape.isValid(), name + " is not a valid solid"
        assert len(shape.Solids()) >= 1
        p = os.path.join(STL_DIR, name + ".stl")
        f.export_stl(f.to_print(name, shape), p)
        stl_info[name] = finalize_stl(p)
    print(f"exported STL to {STL_DIR}")
    step_dir = os.path.join(HERE, "step")
    os.makedirs(step_dir, exist_ok=True)
    import cadquery as cq
    asm = cq.Assembly(name="rabbit_feeder")
    for name, shape in parts.items():                 # assembly pose, opens directly in FreeCAD
        cq.exporters.export(f.W(shape), os.path.join(step_dir, name + ".step"))
        asm.add(f.W(shape), name=name, color=cq.Color(*[c / 255 for c in COLORS[name]]))
    asm.save(os.path.join(step_dir, "rabbit_feeder_assembly.step"))
    print(f"exported STEP to {step_dir}")
    report, ok = run_checks(parts)
    rows = ["", "## STL validation (reloaded with trimesh)", "", "| result | file | triangles | volume (ml) | extents (mm) |", "|---|---|---|---|---|"]
    for name, i in stl_info.items():
        good = i["watertight"]
        ok &= good
        rows.append(f"| {'PASS' if good else '**FAIL**'} | stl/{name}.stl | {i['tris']} | {i['volume_ml']:.1f} | "
                    + " x ".join(f"{x:.1f}" for x in i["extents"]) + " |")
    report += "\n".join(rows) + "\n"
    with open(os.path.join(DOC_DIR, "checks.md"), "w", encoding="utf-8") as fh:
        fh.write(report)
    print(report)
    if render:
        size = render_assembly(parts, os.path.join(DOC_DIR, "assembly.png"))
        print("rendered docs/assembly.png", size)
    return 0 if ok else 1


if __name__ == "__main__":
    sys.exit(main(render="--no-render" not in sys.argv))
