vickussya/baya_feeder/(commit log)

2026-10-19 Add parametric automatic rabbit feeder (CadQuery), STL/STEP parts, FreeCAD assembly, firmware and docs
    [01_hopper_body.step, 01_hopper_body.stl, 02_hopper_lid.step, 02_hopper_lid.stl, 03_wheel_housing.step, 03_wheel_housing.stl, 03b_bearing_cap.step, 03b_bearing_cap.stl]
2026-10-19 Docs: beginner-friendly README with inside/mechanism/electronics/exploded/print/wiring diagrams
